ikatkov/inverting-psu/kicad/short-circuit-board/short-circuit-board.kicad_pcb

## KiCad design kicad/short-circuit-board/short-circuit-board.kicad_pcb (2023-04-22)

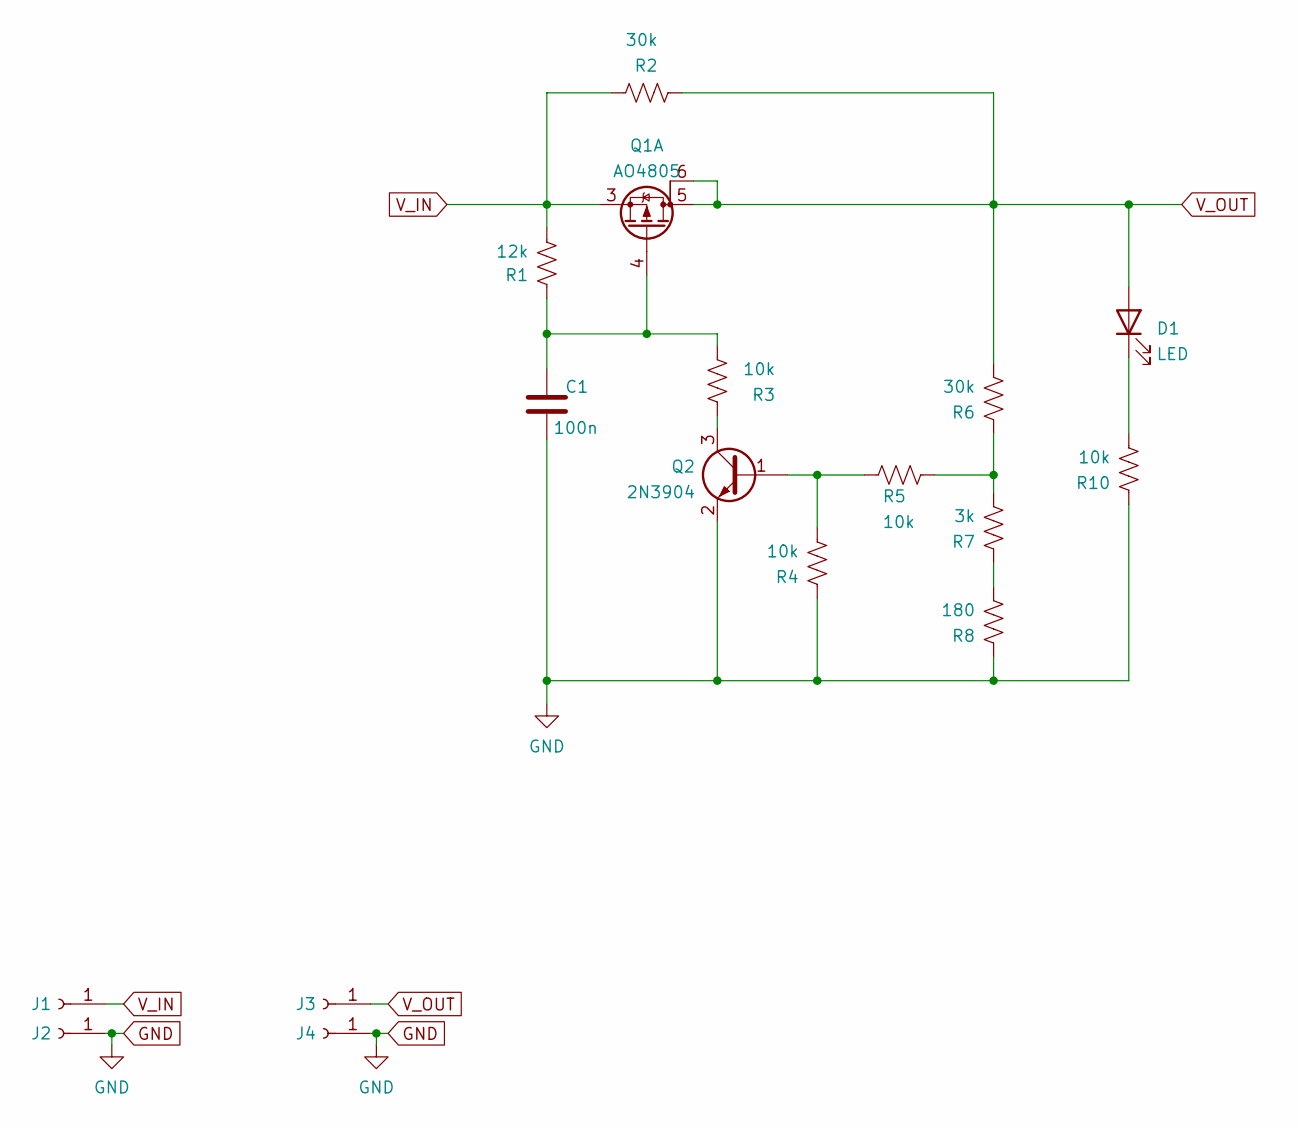
[picture p34: schematic short-circuit-board.kicad_sch]

Parts:
C1: 100n; C_1206_3216Metric
D1: LED; LED_0805_2012Metric
J1: Vin; SolderWire-0.5sqmm_1x01_D0.9mm_OD2.3mm
J2, J4: GND; SolderWire-0.5sqmm_1x01_D0.9mm_OD2.3mm
J3: Vout; SolderWire-0.5sqmm_1x01_D0.9mm_OD2.3mm
Q1: AO4805; SOIC-8_3.9x4.9mm_P1.27mm
Q2: 2N3904; SOT-23
R1: 12k; R_0805_2012Metric
R2, R6: 30k; R_0805_2012Metric
R3, R4, R5, R10: 10k; R_0805_2012Metric
R7: 3k; R_0805_2012Metric
R8: 180; R_0805_2012Metric

Connections:
GND: C1.2, J2.1, J4.1, Q2.2 (E), R4.1, R8.1, R10.1
unnamed: C1.1, Q1.4 (G1), R1.1, R3.2
unnamed: D1.1 (K), R10.2
unnamed: Q2.1 (B), R4.2, R5.2
unnamed: Q2.3 (C), R3.1
unnamed: R5.1, R6.1, R7.2
unnamed: R7.1, R8.2
V_IN: J1.1, Q1.3 (S1), R1.2, R2.1
V_OUT: D1.2 (A), J3.1, Q1.5 (D1), Q1.6 (D1), R2.2, R6.2

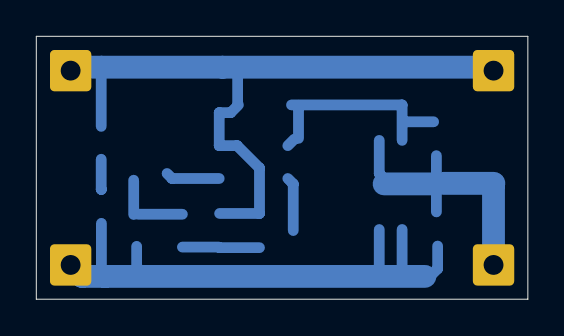
[picture p35: board short-circuit-board.kicad_pcb from above]

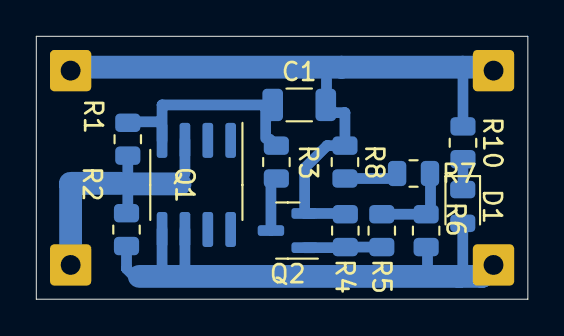
[picture p36: board short-circuit-board.kicad_pcb from below]

Board: 4 copper layers, 27.3 x 14.6 mm, 17 parts (17 on the bottom side), 9 nets.
