ikatkov/inverting-psu/kicad/psu-board/psu-board.kicad_pcb

## KiCad design kicad/psu-board/psu-board.kicad_pcb (2023-04-22)

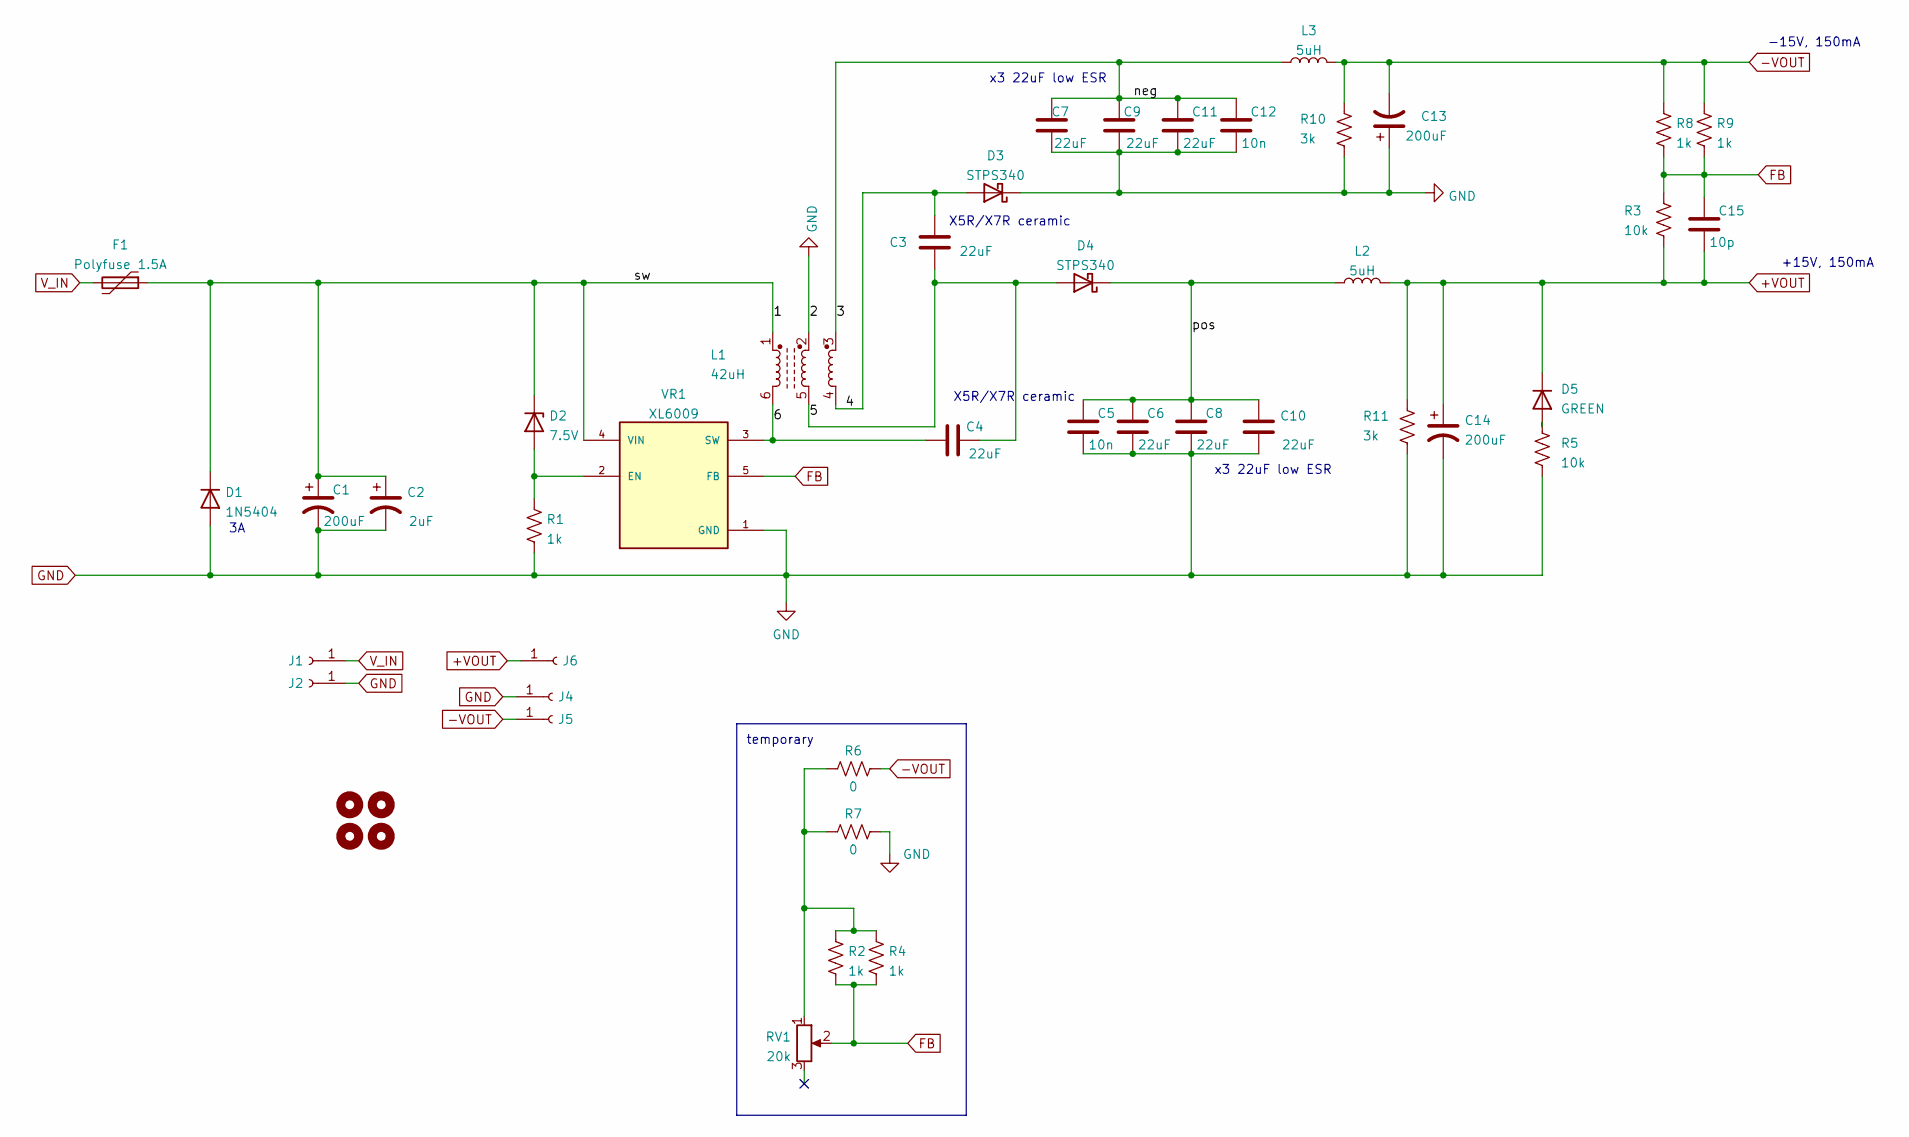
[picture p37: schematic psu-board.kicad_sch]

Parts:
C1, C13, C14: 200uF; CP_Radial_D10.0mm_P5.00mm
C2: 2uF; C_1206_3216Metric
C3, C4, C6, C7, C8, C9, C10, C11: 22uF; C_1206_3216Metric
C5, C12: 10n; C_1206_3216Metric
C15: 10p; C_1206_3216Metric
D1: 1N5404; D_DO-41_SOD81_P3.81mm_Vertical_AnodeUp
D2: 7.5V; D_MiniMELF
D3, D4: STPS340; D_SMB
D5: GREEN; LED_D5.0mm
F1: Polyfuse 1.5A; R_1812_4532Metric
H1, H2, H3, H4: MountingHole; MountingHole_3mm
J1: Vin; SolderWire-0.5sqmm_1x01_D0.9mm_OD2.3mm
J2, J4: GND; SolderWire-0.5sqmm_1x01_D0.9mm_OD2.3mm
J5: Vout-; SolderWire-0.5sqmm_1x01_D0.9mm_OD2.3mm
J6: Vout+; SolderWire-0.5sqmm_1x01_D0.9mm_OD2.3mm
L1: 42uH; inductor-3filar
L2, L3: 5uH; CP_Radial_D6.3mm_P2.50mm
R1, R2, R4, R8, R9: 1k; R_0805_2012Metric
R3, R5: 10k; R_0805_2012Metric
R6, R7: 0; R_0805_2012Metric
R10, R11: 3k; R_0805_2012Metric
RV1: 20k; Potentiometer_Bourns_3296W_Vertical
VR1: XL6009; XL6009-DPAK; PARTREV 1.1

Connections:
+VOUT: C14.1, C15.2, D5.1 (K), J6.1, L2.2, R3.2, R11.1
-VOUT: C13.2, J5.1, L3.2, R6.2, R8.1, R9.1, R10.1
/1: C1.1, C2.1, D1.1 (K), D2.1 (K), F1.1, L1.1, VR1.4 (VIN)
/3: C7.2, C9.2, C11.1, C12.1, L1.3, L3.1
/4: C3.2, D3.2 (A), L1.4
/5: C3.1, C4.2, D4.2 (A), L1.5
/6: C4.1, L1.6, VR1.3 (SW)
/pos: C5.1, C6.1, C8.1, C10.1, D4.1 (K), L2.1
FB: C15.1, R2.2, R3.1, R4.2, R8.2, R9.2, RV1.2, VR1.5 (FB)
GND: C1.2, C2.2, C5.2, C6.2, C7.1, C8.2, C9.1, C10.2, C11.2, C12.2, C13.1, C14.2, D1.2 (A), D3.1 (K), J2.1, J4.1, L1.2, R1.2, R5.2, R7.2, R10.2, R11.2, VR1.1 (GND)
unnamed: D2.2 (A), R1.1, VR1.2 (EN)
unnamed: D5.2 (A), R5.1
unnamed: R2.1, R4.1, R6.1, R7.1, RV1.1
V_IN: F1.2, J1.1

Notes on the sheet:
x3 22uF low ESR
-15V, 150mA
X5R/X7R ceramic
temporary
+15V, 150mA

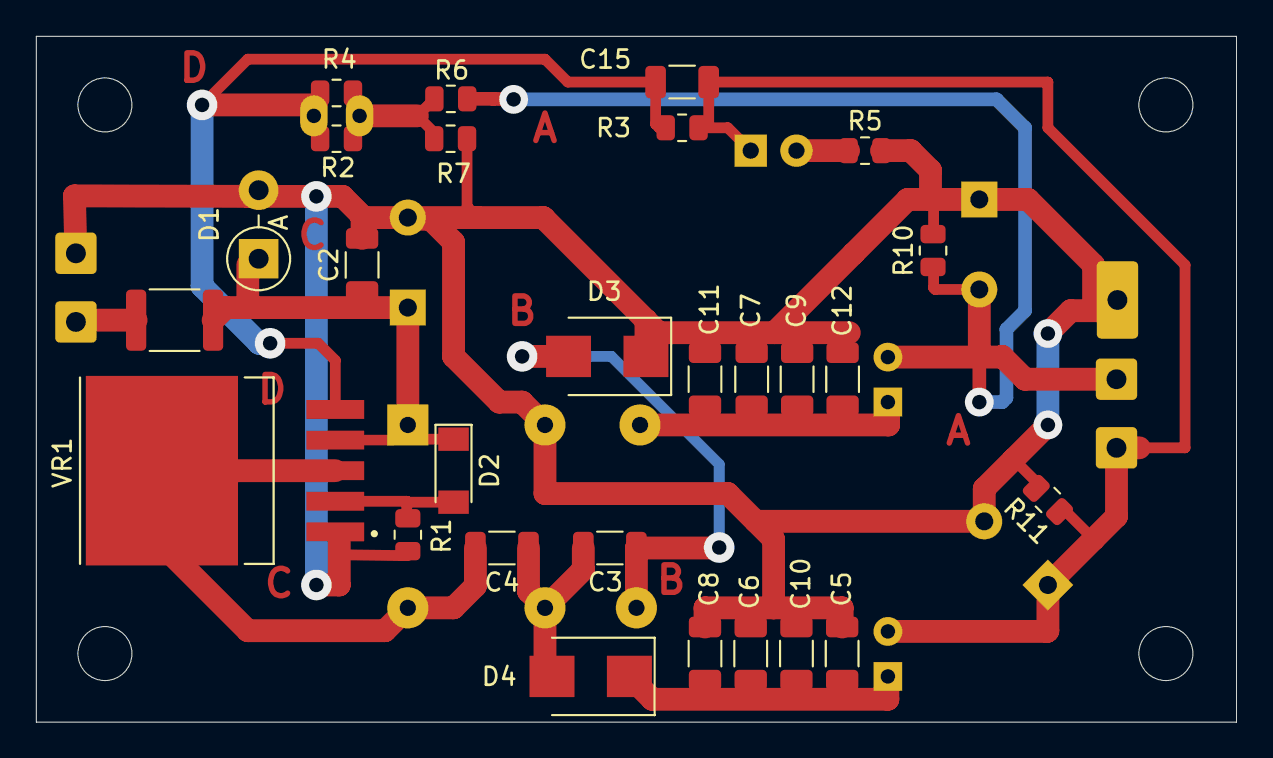
[picture p38: board psu-board.kicad_pcb from above]

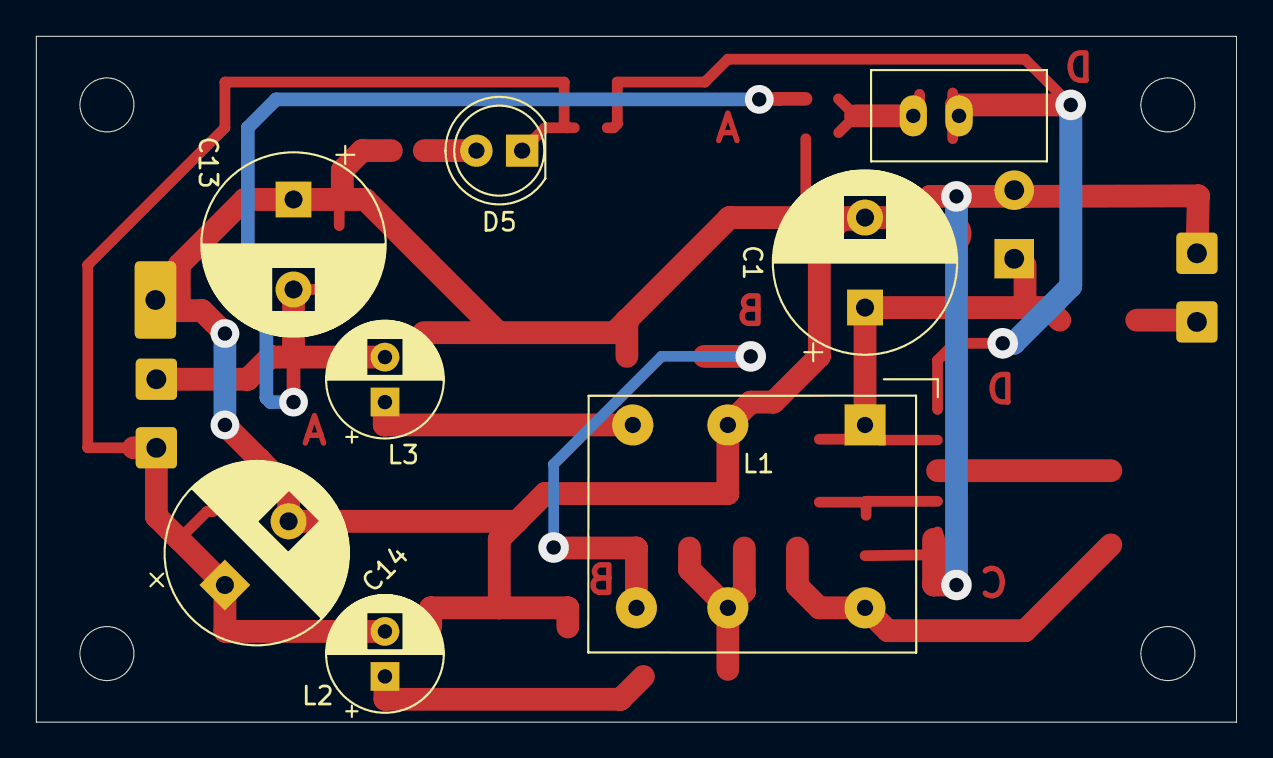
[picture p39: board psu-board.kicad_pcb from below]

Board: 4 copper layers, 66.7 x 38.1 mm, 44 parts (8 on the bottom side), 14 nets.
